Svenwiersema/Macro-TKL-Keyboard/README.md

# Macro-TKL-Keyboard
a small keyboard with a couple of buttons that my 60% keyboard doesnt have
